TCA965/CodeblockSwitcher/PCB/BOM_PCB_Codeblock Switcher_2023-02-20.csv

ID | Name | Designator | Footprint | Quantity | Manufacturer Part
1 | Programmer | ICSP | HDR-TH_6P-P2.54-V-R2-C3-S2.54 | 1 | Header-Male-2.54_2x3
2 | 250-203 | 3LB_IN,3LB_OUT,LED_OUT,SWITCH_IN | CONN-TH_250-203 | 4 | 250-203
3 | 250-202 | GND/VCC,K-LINE | CONN-TH_250-202 | 2 | 250-202
4 | 54102-T0600LF | UART | HDR-TH_2P-P2.54-V-M-R2-C1-S2.54 | 1 | 54102-T0600LF
5 | TS5A23159DGSR | U4,U3 | VSSOP-10_L3.0-W3.0-P0.50-LS4.9-BL | 2 | TS5A23159DGSR
6 | 100nF | C1,C3,C4,C7,C8,C9,C10,C11 | C0603 | 8 | 0603B104K500NT
7 | 100uF | C2 | CAP-SMD_BD6.3-L6.6-W6.6-FD | 1 | RVT1E101M0607
8 | 22pF | C5,C6 | C0805 | 2 | 0805CG220J500NT
9 | SMBJ14CA | D1 | SMB_L4.3-W3.6-LS5.4-BI | 1 | SMBJ14CA
10 | MBR130T3G | D2,D8,D9,D10 | SOD-123_L2.7-W1.6-LS3.7-RD-1 | 4 | MBR130T3G
11 | CD4148WSP | D3 | D0805-RD | 1 | CD4148WSP
12 | BAS40 | D4,D5,D6,D7 | SOT-23-3_L2.9-W1.6-P1.90-LS2.8-BR | 4 | BAS40-04LT1G
13 | CFS12V6TR50 | F1 | F1206 | 1 | CFS12V6TR50
14 | BC817 | Q1,Q3,Q4,Q6,Q8 | SOT-323-3_L2.0-W1.3-P1.30-LS2.1-BR | 5 | BC817W
15 | BC807 | Q2,Q5,Q7 | SOT-323-3_L2.0-W1.3-P1.30-LS2.1-BR | 3 | BC807-40W,115
16 | 10K | R1,R2,R5,R6,R7,R9,R10,R11,R12,R14,R17 | R0805 | 11 | TR0805B10KP0525
17 | 1K | R3,R4,R8,R13,R15,R16,R18 | R0805 | 7 | 0805WAD1001T5E
18 | 3.3K | R1_OPT,R2_OPT,R10_OPT | R0805 | 3 | RC0805FR-073K3L
19 | CJ7805 3% | U1 | TO-252-2_L6.6-W6.1-P4.58-LS10.1-BR-CW | 1 | CJ7805 3%
20 | ATMEGA328PB-AU | U2 | TQFP-32_L7.0-W7.0-P0.80-LS9.0-BL | 1 | ATMEGA328PB-AU
21 | 16MHz | X1 | HC-49S_L11.4-W4.8 | 1 | X49SM16MSD2SC
