TCA965/CodeblockSwitcher/PCB/Schematic_Codeblock Switcher_2023-02-20.pdf

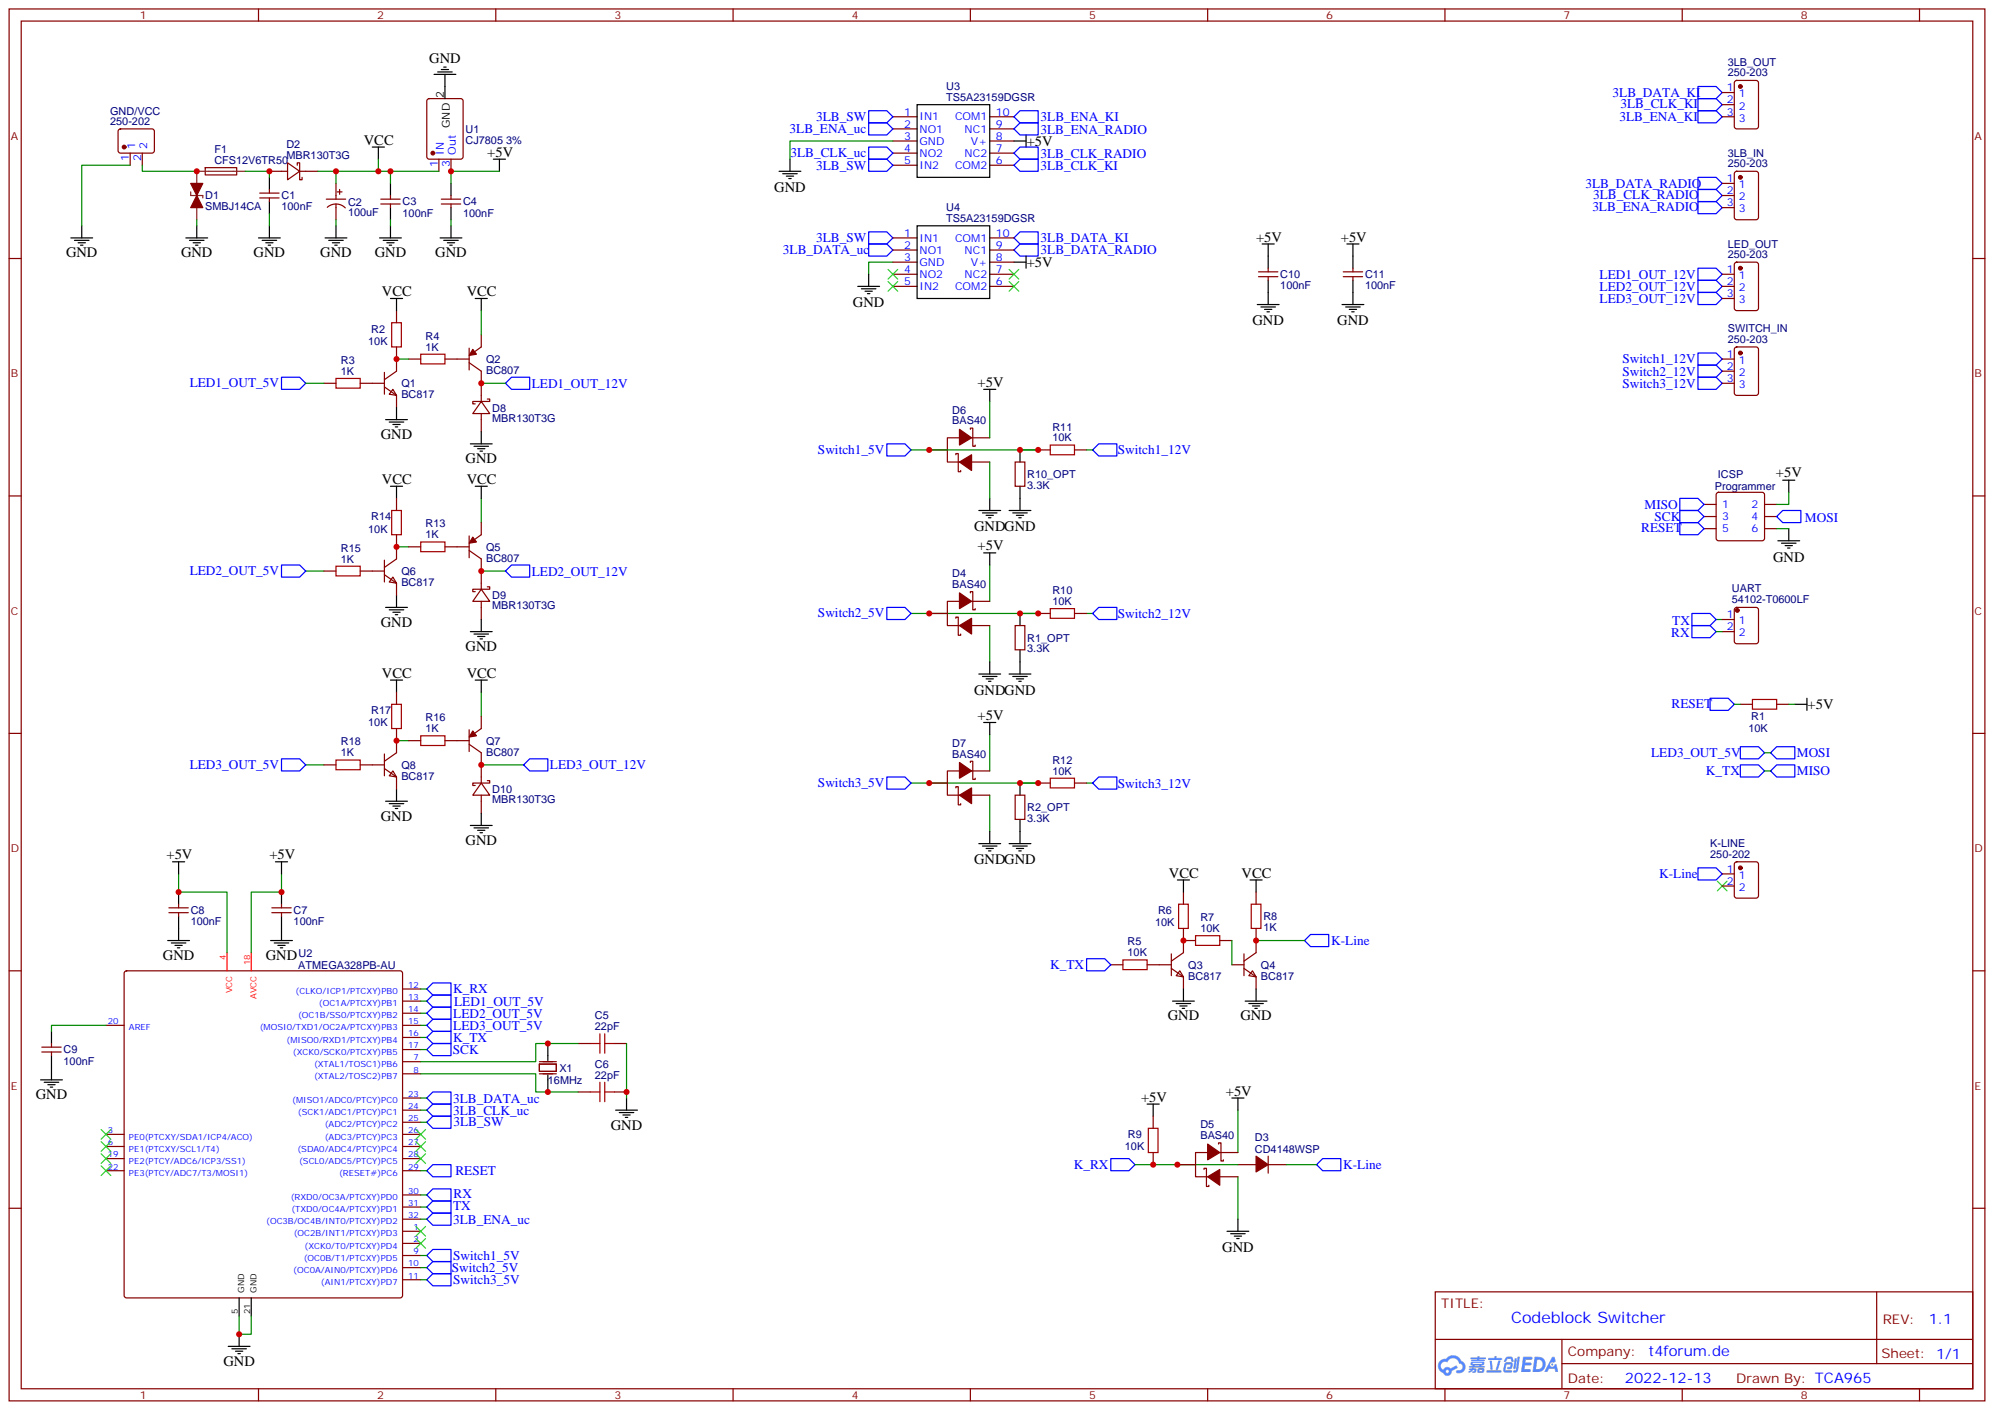
[picture p1: page 1]
